rahul-sb/EIT/docs/Circuit Diagram.png

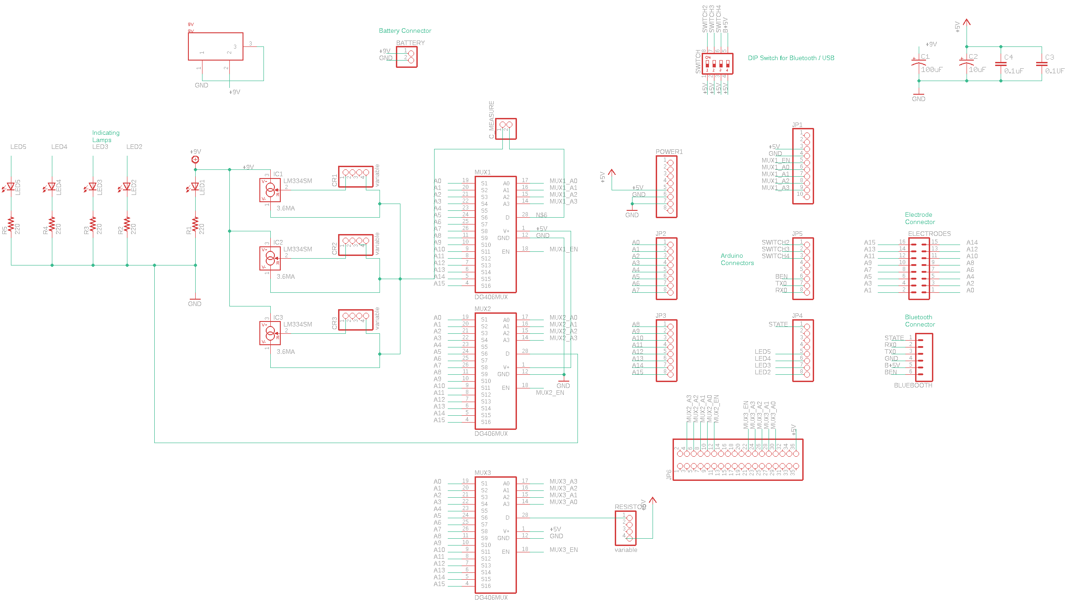
docs/Circuit Diagram.png
