rahul-sb/EIT/(commit log)

2019-03-06 Added support for different current injection patterns.
2019-07-30 Added circuit diagram
